WarmT/BLDC-CTRL-UART/README.md

# BLDC-controller
BLDC controller based on STSPIN32F0

Finished PCBs:
Top
